ahmed-salama7/Solar-BEMS/hardware/schematic/index.html

# ⚡ Solar BEMS — PCB Schematic

＋ Zoom in － Zoom out ⌂ Reset Pin labels ON Net labels ON Scroll = zoom | Drag = pan | Hover component = details

Hover a component for details

Solar BEMS — 11 subsystem blocks · Pin-level connections
25 Wp PV → 3S Li-ion + BMS → 5V MCU rail → Arduino MPPT

### Legend

Power generation

Sensing / monitoring

Power conversion

Energy storage

MCU control

Output load

+V_PV (solar input)

+5V_MCU rail

V_BATT bus (P+)

SW node (switching)

I2C bus (SDA/SCL)

1-Wire / gate / PWM

GND / power return
