ahmed-salama7/Solar-BEMS/images/figB1_firmware_flowchart.png

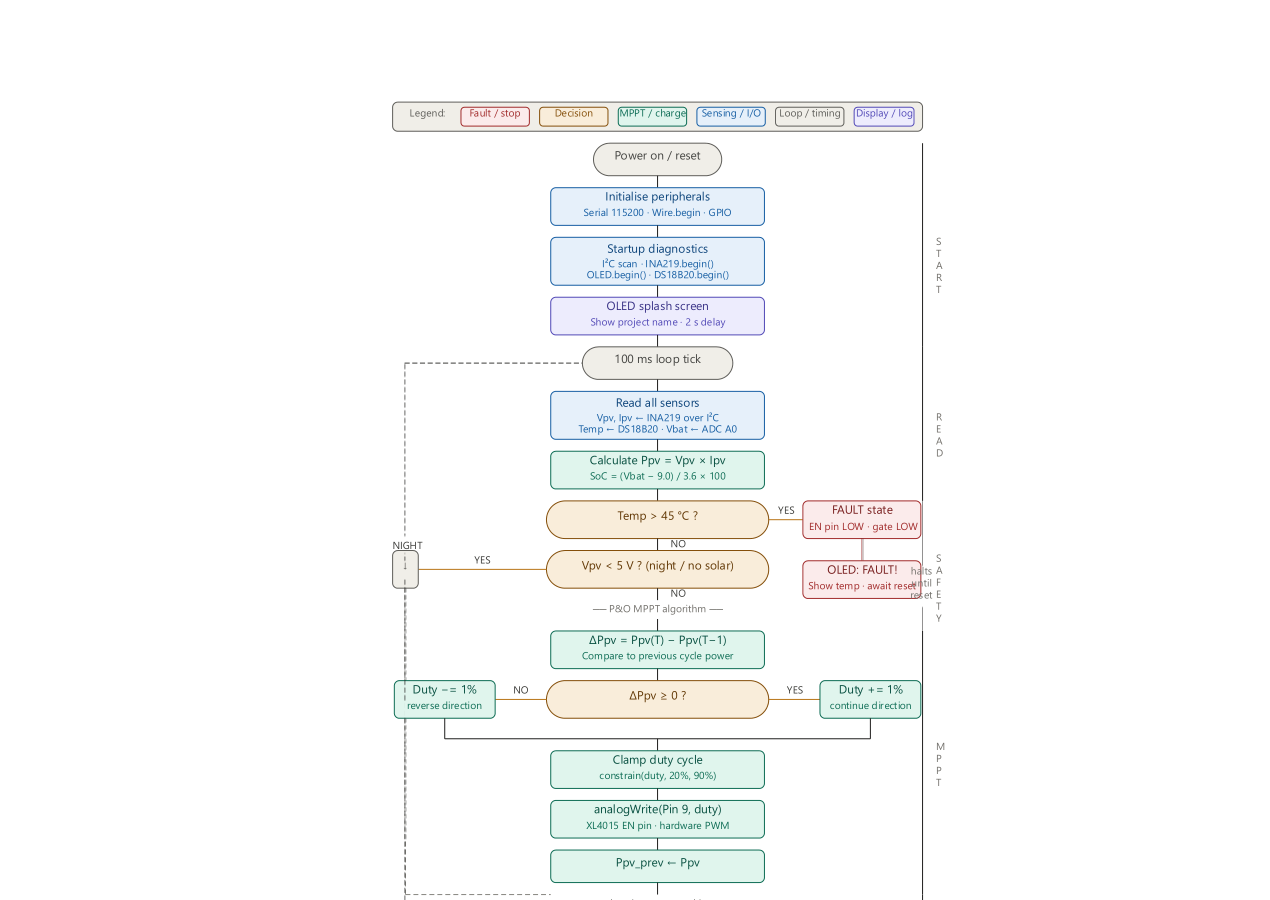
images/figB1_firmware_flowchart.png
