ahmed-salama7/Solar-BEMS/hardware/Solar_BEMS_BOM.xlsx

Sheet: Bill of Materials
SOLAR PANEL–BASED BATTERY ENERGY MANAGEMENT SYSTEM
Bill of Materials (BOM) — Implementation Phase | Istanbul Arel University · EEE Dept.
Student: Ahmed Salama |  |  |  |  |  | Prices to be filled in after purchase ▶ Unit Price column is editable (yellow)
Category colour legend: ICs / Active Inductors Diodes Capacitors Resistors Modules / Connectors / Misc
# | Reference(s) | Category | Description | Value / Specification | Qty | Package / Form | Notes — Values & Purpose | Unit Price | Total Price | Procured? | Supplier / Link
1 | U1 | ICs / Active | INA219 Power Monitor | INA219AIDR, I2C, 26V | 1 | SOT-23-8 or breakout module | Measures V_PV and I_PV via 0.1Ω shunt. I2C address 0x40 (A0=GND, A1=GND). VCC = 3.3–5.5V. Pin map on schematic: VCC, GND, IN+, IN−, SDA, SCL, A0, A1. If buying breakout module (e.g. Adafruit or generic blue module), all support components (decoupling cap, pull-ups) may already be included — check before ordering extras. | ₺100.00 |  | Yes
2 | U2 | ICs / Active | XL4015 CC/CV Buck Converter | XL4015, 5A, 8–36V in, 180kHz | 1 | Module (3-screw CV+CC) or SOP-8 IC | Charges 3S Li-ion pack. Steps ~20.8V PV (Vmp) down to 12.6V. 3-screw module version has separate CV trim pot and CC trim pot — easiest for prototyping. Pre-set: Output V to 12.60V (CV threshold), Current limit to ~1.2A (CC). EN pin controlled by Arduino pin 9 PWM for MPPT. Heatsink required if >2A sustained. | ₺100.00 |  | Yes
3 | U4 | ICs / Active | LM2596 Adjustable Buck Converter | LM2596S-ADJ, 3A, 40V, 150kHz | 1 | Module or TO-263-5 | Provides regulated +5V_MCU rail for Arduino + all peripherals. Fed from V_BATT bus (10–12.6V). Set output to exactly 5.0V using R6/R7 feedback divider (R6=10kΩ, R7=3.3kΩ → V_out = 1.23×(1 + R6/R7) = 5.0V). ON/OFF pin tied to GND = always enabled. | ₺55.00 |  | No | https://www.robotistan.com/mini-ayarlanabilir-3a-voltaj-regulator-karti-lm2596-adj?language=tr&h=28cecc02
4 | Q1 | ICs / Active | IRLZ44N Logic-Level N-MOSFET | IRLZ44N, 55V, 47A, R_DS=22mΩ | 1 | TO-220 | Electronic load switch. Gate driven by Arduino pin 8 via 100Ω series resistor R10 and 10kΩ pull-down R11. VGS(th) = 1–2V → fully ON at 5V logic drive. Drain: V_BATT bus in; Source: to load (J3). Add heatsink if fan current > 2A. D4 flyback diode across drain-source is mandatory for inductive loads. | ₺35.00 |  | No | https://www.robolinkmarket.com/irfz44-49a-55v-mosfet-to220-mosfet
5 | ARD1 | ICs / Active | Arduino Mega 2560 | ATmega2560, 16MHz, 5V | 1 | Through-hole dev board | Central controller. Runs: P&O MPPT (reads INA219 via I2C on pins 20/21 SDA/SCL, outputs PWM on pin 9 to XL4015 EN); battery CC/CV logic; LVD load switching (pin 8→Q1.Gate); temp monitoring (pin 2, 1-Wire DS18B20); OLED update loop (I2C on pins 20/21 to SSD1306 address 0x3C). Powered from LM2596 +5V rail via VIN pin. Required libraries: Wire.h, Adafruit_INA219, Adafruit_SSD1306, OneWire, DallasTemperature. | ₺200.00 |  | No
6 | BMS1 | Modules | XR-121 3S 20A Li-ion BMS Module | 3S, 20A cont., 4.2V/cell OVP | 1 | PCB module (≈35×7mm typical) | Cell-level protection for 3-cell series 18650 pack. Connections: B+ (pack positive), B− (pack negative), C1 (tap cell1/2 junction), C2 (tap cell2/3 junction). Output: P+ and P− — ALL system power flows through here. Protects against: overcharge (4.25V/cell cutoff), overdischarge (2.5V/cell), overcurrent (20A), short circuit. Performs passive cell balancing. Do NOT bypass P+/P−. | ₺70.00 |  | Yes
7 | SSD1 | Modules | OLED Display Module 0.96″ | SSD1306, 128×64px, I2C | 1 | Module with 4-pin header | Real-time monitoring display. I2C address 0x3C (default — verify on module PCB). VCC = 3.3–5V from +5V_MCU rail. Shares I2C bus with INA219 (address 0x40). Displays: V_PV, I_PV, P_PV, V_BAT, Temp°C, System Mode label (CHARGING / FULL / LOAD OFF / FAULT). Do NOT add extra I2C pull-up resistors here — R1 & R2 (B2 block) already pull up the bus. | ₺200.00 |  | No
8 | BT1–BT3 | Battery / Storage | 18650 Li-ion Cells (×3) | 3.7V nominal, ≥2000mAh, flat-top | 3 | 18650 cylindrical | Three cells in series (3S) = 11.1V nominal, 12.6V fully charged. Use flat-top (unprotected) cells — the BMS module provides protection. Recommended brands: Samsung 25R, LG HG2, Molicel P26A, or equivalent quality cells. Do NOT use cheap no-brand cells — capacity and safety not guaranteed. Weld or use holder — never solder directly to cell terminals. | ₺70.00 |  | Yes
9 | BH1 | Battery / Storage | 3S 18650 Battery Holder | 3-cell series, spring contacts | 1 | 3×18650 plastic holder | Holds three 18650 cells in series configuration (3S). Must have solder tabs or wire leads for B+, B−, and cell tap points (C1, C2) for BMS balancing. If holder has no tap wires, add tap point leads manually between cells. Secure holder to chassis/PCB with M3 screws or adhesive. | ₺30.00 |  | Yes
10 | L1 | Inductors | Power Inductor — XL4015 Charger | 68µH, ≥5A DC rated, low DCR | 1 | CDRH127 or similar (SMD) / Radial | Sits on XL4015 SW (switching) node — CRITICAL layout node. Trace from SW pin → L1 → output must be as short and wide as possible. Low DCR (DC resistance) essential for efficiency — aim <0.15Ω. Example parts: Bourns SRR1260-680M, TDK SLF12565T-680M4R7-PF, or equivalent 68µH/5A. | ₺15.00 |  | No
11 | L2 | Inductors | Power Inductor — LM2596 5V Supply | 68µH, ≥3A DC rated | 1 | CDRH127 or radial through-hole | Sits on LM2596 OUT (switching) node. Same layout rules as L1. 3A rating matches LM2596 maximum output current. Example parts: Bourns SRR1260-680M (same part as L1), or any 68µH/3A power inductor. | ₺15.00 |  | No
12 | D1 | Diodes | Schottky Diode — Reverse Polarity Protection | 1N5822, 40V, 3A | 1 | DO-201AD (axial) | Reverse polarity protection on +V_PV rail after fuse F1. Anode: from fuse F1 OUT. Cathode: to +V_PV rail. Schottky chosen for low Vf (~0.32V) to minimize power dissipation. Alternative: SB340, SS34 (SMD). Do NOT use 1N4001–1N4007 (1V Vf = too much loss). | ₺15.00 |  | No
13 | D2 | Diodes | Schottky Diode — XL4015 Freewheeling (Catch) | SS54, 40V, 5A | 1 | DO-214AB (SMA) or SB540 | Catch diode on XL4015 SW node. Cathode → SW pin; Anode → GND (PGND). MUST be Schottky — a 1N4007 would fail at 180kHz switching frequency due to slow reverse recovery. 5A rating matches XL4015 maximum switch current. Place as close to XL4015 SW and GND pins as physically possible to minimize loop area. | ₺15.00 |  | No
14 | D3 | Diodes | Schottky Diode — LM2596 Freewheeling | 1N5822, 40V, 3A | 1 | DO-201AD (axial) or SB340 | Freewheeling/catch diode on LM2596 OUT (switching) node. Same principle as D2. Cathode → LM2596 OUT pin; Anode → GND. Can use same part number as D1 (1N5822) for BOM consolidation. | ₺15.00 |  | No
15 | D4 | Diodes | Rectifier Diode — MOSFET Flyback | 1N4007, 1000V, 1A | 1 | DO-41 (axial) | Flyback/freewheeling diode across Q1 (IRLZ44N) drain-source. Cathode → Q1 Drain (V_BATT side); Anode → Q1 Source (GND side). Protects MOSFET from inductive kick when 12V DC fan motor is switched OFF. 1N4007 acceptable here — switching is slow (LVD events), so reverse recovery not critical. | ₺40.00 |  | No
16 | TVS1 | Diodes | TVS Diode — PV Surge Clamp | P6KE24A, 24V clamp, 600W peak | 1 | DO-204AC (axial) | Transient voltage suppressor across +V_PV bus. Cathode → +V_PV rail; Anode → GND. Clamps voltage spikes from long PV panel wiring inductance to 24V. Protects XL4015 VIN pin and INA219 IN+ from transient overvoltage. Bidirectional TVS (e.g. 1.5KE24CA) also acceptable. | ₺20.00 |  | No
17 | C1, C6, C8 | Capacitors — Electrolytic | Electrolytic Cap — 470µF / 35V or 25V | 470µF, 35V (C1) / 25V (C6, C8) | 3 | Radial, 10mm dia. typical | C1 (470µF/35V): bulk cap on +V_PV rail after reverse-polarity diode D1. C6 (470µF/25V): output cap on XL4015 charger output (CHGR_OUT → battery). C8 (470µF/25V): bulk cap on V_BATT bus (BMS P+ output). Use low-ESR 105°C rated caps throughout for reliability. Voltage ratings must exceed max voltage on each respective net with margin. | ₺50.00 |  | No
18 | C10, C15 | Capacitors — Electrolytic | Electrolytic Cap — 100µF / 25V | 100µF, 25V | 2 | Radial, 6.3–8mm dia. | C10: input cap on LM2596 VIN from V_BATT bus. C15: output cap at load terminal J3 — handles DC fan motor startup inrush current. Low-ESR 105°C rated. | ₺30.00 |  | No
19 | C12 | Capacitors — Electrolytic | Electrolytic Cap — 220µF / 16V | 220µF, 16V | 1 | Radial | C12: output filter cap on LM2596 +5V_MCU rail. Low-ESR type important — high-ESR caps can cause LM2596 output voltage oscillation. 16V rating provides safe margin above 5V output. | ₺20.00 |  | No
20 | C_MCU | Capacitors — Electrolytic | Electrolytic Cap — 100µF / 16V | 100µF, 16V | 1 | Radial | Bulk decoupling cap on Arduino VIN pin. Absorbs supply transients during MCU burst activity and I2C communication spikes. Prevents 5V rail drooping under Arduino dynamic current draw (~40mA peaks). | ₺15.00 |  | No
21 | C4 | Capacitors — Ceramic | Ceramic Cap — 10µF / 50V X7R | 10µF, 50V, X7R dielectric | 1 | 1210 SMD or radial through-hole | C4: input cap at XL4015 VIN pin. Supply instantaneous switch turn-on current. X7R dielectric maintains capacitance over the PV voltage range (0–24.6V). MUST be placed within 2mm of XL4015 VIN and GND pins on PCB. | ₺30.00 |  | No
22 | C2, C3, C5, C7, C9, C11, C13, C14, C16 | Capacitors — Ceramic | Ceramic Cap — 100nF / 50V (×9) | 100nF (0.1µF), 50V, X7R or X5R | 9 | 0805 SMD or radial 2.54mm | High-frequency bypass/decoupling caps. One per IC VCC pin (minimum). C2: parallel with C1 on +V_PV. C3: INA219 VCC decoupling. C5: parallel with C4 on XL4015 VIN. C7: parallel with C6 on charger output. C9: DS18B20 VDD decoupling. C11: LM2596 VIN HF bypass. C13: LM2596 output HF bypass. C14: RC filter on V_BAT_ADC divider midpoint (with R8‖R9). C16: OLED SSD1306 VCC decoupling. Place each cap within 1–2mm of the IC pin it serves on the PCB. | ₺22.00 |  | No
23 | R1–R11, R_LED | Resistors | Resistors (12 values — see notes) | Various — 1% tolerance recommended | 12 | 0805 SMD or axial 1/4W | Full list of required values and functions: • R1 4.7kΩ — I2C SDA pull-up to +5V (shared bus — only one set needed) • R2 4.7kΩ — I2C SCL pull-up to +5V (shared bus) • R3 91kΩ (or 100kΩ) — XL4015 FB upper divider resistor (sets V_out = 12.6V with R4=10kΩ) • R4 10kΩ — XL4015 FB lower divider resistor • R5 4.7kΩ — DS18B20 DQ line pull-up to +5V (1-Wire protocol — mandatory) • R6 10kΩ — LM2596 FB upper divider (sets V_out = 5.0V with R7=3.3kΩ) • R7 3.3kΩ — LM2596 FB lower divider • R8 10kΩ — Battery voltage divider top (V_BATT → midpoint) • R9 3.3kΩ — Battery voltage divider bottom (midpoint → GND); scales 12.6V → 3.13V for Arduino A0 • R10 100Ω — Q1 MOSFET gate series resistor (limits gate current, damps ringing) • R11 10kΩ — Q1 gate pull-down to GND (ensures MOSFET is OFF when Arduino resets) • R_LED 1kΩ — Current-limiting resistor for power indicator LED1 Tip: buy a resistor kit (600-piece assortment) — covers all values above and future needs. | ₺7.00 |  | Yes
24 | J1 | Connectors | PV Panel Input Screw Terminal | 2-pin, 5.08mm pitch, ≥5A rated | 1 | PCB screw terminal or wire-to-board | Solar panel input connector. Pin 1: +PV (positive). Pin 2: GND. 5.08mm pitch (0.2") is standard for power screw terminals. Rate ≥5A for panel short-circuit current margin. Use green or blue terminal blocks (industry standard). | ₺20.00 |  | No
25 | J2 | Connectors | Battery Pack Connector | 4-pin JST-XH or screw terminal | 1 | JST-XH 2.54mm or 5.08mm screw | Connects to 3S 18650 pack. 4 signals: B+, B−, C2 (cell tap 2/3), C1 (cell tap 1/2). B+/B− wires: 20AWG minimum (carry full charge/discharge current). C1/C2 wires: 26AWG acceptable (carry only BMS balancing µA). Label all 4 positions clearly on PCB silkscreen. | ₺10.00 |  | No
26 | J3 | Connectors | Load Output Screw Terminal | 2-pin, 5.08mm pitch, ≥5A rated | 1 | PCB screw terminal | Output to 12V DC fan (or other load). (+): switched output from Q1 drain; (−): power GND. This sees full battery bus voltage when Q1 is ON. Wires minimum 20AWG. | ₺20.00 |  | No
27 | J4 | Connectors | OLED Display Connector | 4-pin 2.54mm header | 1 | Pin header (male or female) | Connects SSD1306 OLED module. Pinout: VCC, GND, SDA, SCL. Match the pin order on your specific OLED module (not all modules have the same order!). Use female socket on PCB, male pins on OLED module. | ₺40.00 |  | No
28 | J5 | Connectors | ICSP Programming Header | 6-pin 2.54mm, 2×3 layout | 1 | Pin header 2×3 | Standard ICSP header for direct AVR firmware programming via USBasp or ArduinoISP. Pinout (standard): MISO, VCC, SCK, MOSI, RESET, GND. Use even if Arduino Mega 2560 is installed as main MCU — good practice for production/debugging. | ₺45.00 |  | Yes
29 | J6 | Connectors | UART Debug Header | 4-pin 2.54mm, 1×4 layout | 1 | Pin header 1×4 | Serial debug port. Pinout: TX, RX, VCC, GND. Connect a CH340G/CP2102/FTDI USB-UART module for Serial Monitor during firmware development. Arduino TX→adapter RX and Arduino RX→adapter TX (cross connection). | ₺50.00 |  | No
30 | F1 | Mechanical / Safety | Fuse — 5A + Fuse Holder | 5A, 250V, slow-blow or fast-blow | 1 | PCB fuse holder (5×20mm glass or blade) | First line of overcurrent protection. In series on +V_PV positive rail immediately after J1. Breaks on sustained short circuit or overload protecting all downstream components. Use automotive blade holder or panel-mount holder for easy field replacement. 5A rating: PV panel max current ~1.38A (25Wp, Isc), so 5A provides protection headroom without nuisance tripping. | ₺65.00 |  | Yes
31 | TP1–TP5 | Mechanical / Safety | Test Points (×5) | Through-hole solder pad | 5 | Keystone 5000 or bare pad | 5 test points on critical nets: • TP1 on +V_PV (PV voltage after protection diode D1) • TP2 on CHGR_OUT (XL4015 charger output — verify 12.6V before battery connection) • TP3 on V_BATT (BMS P+ protected output — actual pack voltage) • TP4 on V_BAT_ADC (voltage divider midpoint — verify ≈3.1V when battery at 12.6V) • TP5 on TEMP_DQ (DS18B20 data line — view 1-Wire pulses with oscilloscope) Use coloured test point loops: red=power, black=GND, yellow=signal. | ₺18.00 |  | No
32 | LED1 | Mechanical / Safety | LED Indicator — Power ON | Green, 3mm, 2.1V Vf, 20mA | 1 | 3mm through-hole | Visual power-on indicator for +5V_MCU rail. Anode via R_LED (1kΩ) from +5V_MCU; Cathode to GND. Current = (5V − 2.1V) / 1kΩ ≈ 2.9mA — dim but visible. Use 470Ω for brighter indication. | ₺11.00 |  | No
33 | PCB1 | Mechanical / Safety | Breadboard (Prototyping) | 830-point, full-size | 1 | 830-point solderless breadboard | For initial prototyping and firmware development before PCB fabrication. Build the circuit on breadboard first to validate all connections, firmware, and thresholds. Only move to PCB once system is fully verified on breadboard. 830 points is sufficient for the full Solar BEMS circuit. | ₺45.00 |  | Yes
34 | LOAD1 | Load Device | 12V DC Fan | 12V DC, 0.1–0.5A, brushless | 1 | 80mm or 120mm PC cooling fan | Output test load and demonstration device. Controlled by Q1 MOSFET switch driven from Arduino pin 8. Inductive load — D4 flyback diode across Q1 drain-source is mandatory. An 80mm PC fan (12V, ~0.2A, 2.4W) is ideal for demonstration. Can also use any 12V resistive/inductive DC load up to Q1's 15A current rating. | ₺50.00 |  | Yes
35 | PV1 | PV Panel | Solar Panel — 25Wp Monocrystalline | Voc=24.62V, Vmp=20.84V, Isc=1.38A | 1 | Rigid glass, ~36×25cm typical | Primary energy source. Monocrystalline for highest efficiency in limited space. Vmp (~20.84V) > battery max voltage (12.6V) → XL4015 buck converter required (correct). Output current at MPP (Imp) ≈ 1.23A. Connect via J1 screw terminal with 20AWG wire. Include a weatherproof junction box on the panel if used outdoors. | ₺900.00 |  | Yes
36 | JP1 | Misc | INA219 Address Jumpers | 2×2 solder pad or 0Ω link | 1 | Solder pads / 0Ω resistor | Sets INA219 I2C address via A0 and A1 pins. Default A0=GND, A1=GND → address 0x40. If 0x40 is occupied, bridge A0 pad to VCC → address 0x41. Can be implemented as solder bridge pads on PCB — no component needed if using 0x40. | ₺80.00 |  | Yes
37 | WIRE | Misc | Hookup Wire — Assorted | 20AWG + 26AWG, multiple colours | 1 | Assortment or by-the-meter | For breadboard prototyping and point-to-point wiring. Power rails (V_PV, V_BATT, GND): use 20AWG red (+) / black (−) silicone wire. Signal wires (I2C, 1-Wire, ADC): use 26AWG solid core for breadboard; 26AWG stranded for off-board sensors (DS18B20 probe cable). Buy a pre-cut jumper wire set for breadboard work. | ₺50.00 |  | No
38 | MISC | Misc | Heatsink + Thermal Tape | Small aluminium heatsink, TO-220 size | 1 | Clip-on or adhesive heatsink | Required for Q1 (IRLZ44N) if load current > 2A, and optionally for XL4015 and LM2596 modules. Apply thermal tape between component tab and heatsink for good thermal contact. TO-220 clip-on heatsinks are inexpensive and widely available. | ₺70.00 |  | No
TOTAL ESTIMATED COST
★ Fill in Unit Price (₺) column after purchasing each component — Total Price and Grand Total calculate automatically. ★ Use the 'Procured?' dropdown (Yes / No / Ordered) to track purchase status. ★ Prices shown are per-unit. Qty column adjusts totals automatically.

Sheet: Cost Summary
SOLAR BEMS — COST SUMMARY BY CATEGORY
Prices auto-populate from 'Bill of Materials' sheet as you fill them in
Category | # Items | Unit Prices Filled | Subtotal (₺) | Notes
ICs / Active |  |  |  | U1, U2, U4, Q1, ARD1 — core active devices
Modules |  |  |  | BMS, OLED, batteries, holder
Inductors |  |  |  | L1, L2 — power inductors for DC-DC converters
Diodes |  |  |  | D1–D4, TVS1 — protection and switching diodes
Capacitors |  |  |  | Electrolytic and ceramic caps (14 total)
Resistors |  |  |  | 12 values — see BOM notes for full list
Connectors |  |  |  | J1–J6 — screw terminals and pin headers
Mechanical / Safety |  |  |  | Fuse, test points, LED, breadboard
Load Device |  |  |  | 12V DC fan load
PV Panel |  |  |  | 25Wp monocrystalline panel
Misc |  |  |  | Jumpers, wire, heatsinks
GRAND TOTAL |  |  |  | Updates automatically as you fill in prices
PROCUREMENT PROGRESS
Metric | Count | Formula / Note
Total line items |  | Total rows in BOM
Marked 'Yes' |  | Physically received
Marked 'Ordered' |  | Ordered, awaiting delivery
Marked 'No' |  | Not yet ordered
% Procured |  | Complete procurement %

Sheet: How to Use
HOW TO USE THIS BOM
FILLING IN PRICES
1. Go to the 'Bill of Materials' sheet.
2. When you buy a component, click its Unit Price cell (column I — highlighted yellow).
3. Type the price you paid (numbers only — the ₺ sign is added automatically).
4. The Total Price (column J) calculates automatically using Qty × Unit Price.
5. The Grand Total at the bottom and the Cost Summary sheet both update instantly.
TRACKING PROCUREMENT
1. In the 'Procured?' column (column K), click the cell for any component.
2. A dropdown will appear — choose: Yes (received), Ordered (awaiting), or No (not bought yet).
3. The Cost Summary sheet tracks how many items are in each status.
IMPORTANT NOTES ON COMPONENTS
• Resistors: buy a full kit (600-piece 1/4W kit covers all 12 values needed).
• Capacitors: 100nF × 9 and 10µF × 1 ceramics are cheapest bought in bulk strips of 10.
• INA219 and SSD1306: available as ready-made modules on AliExpress/Trendyol — easier than buying bare ICs.
• XL4015 and LM2596: also available as pre-built modules — recommended for prototyping.
• Verify the OLED module I2C address (0x3C or 0x3D) — check the A0 pad on the back of the module.
• The 3S BMS module: make sure it has B+, B−, C1, C2 connections for cell balancing.
• Solar panel: buy locally if possible — shipping fragile glass panels is risky and expensive.
ADDING THIS TO YOUR REPORT
• Export this sheet as PDF: File → Export → Export as PDF → select 'Bill of Materials' sheet only.
• Or take a screenshot of rows 1 to the totals row for inclusion in the report appendix.
• Reference the BOM in your report as: 'Table X — Final Bill of Materials, Solar BEMS Implementation Phase'
